santkumar/diya/README.md

# Diya
Light illumination device for cells cultured in multiwell plates or culture dishes

## hardware
- CAD files for hardware designs
- Assembly instructions

## software
- Source code for Diya GUI
- release version: executable files
