santkumar/diya/hardware/CAD_files/README.md

Contains .step and .stl files for all of the 3D printed parts of Diya.
