santkumar/diya/hardware/CAD_files/stands/README.md

This forms the 4 legs/stands of a Diya device. You need to print it 4 times for one set.
