santkumar/diya/hardware/CAD_files/diya_logo/README.md

This is the logo panel for Diya (can be seen in figures in the paper). This is not necessary for the operation of Diya, but it definitely gives a finishing look to the design :)

We would appreciate if you print and attach it on top of your Diya!
