santkumar/diya/hardware/CAD_files/back_plate/back_plate_complete.stl

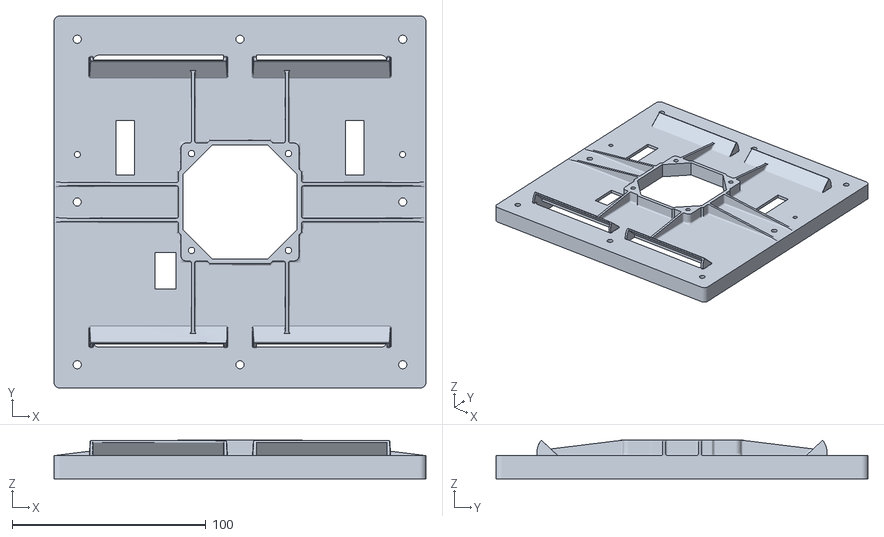
[picture p7: CAD file, 2023-09-17]
hardware/CAD_files/back_plate/back_plate_complete.stl
192.0 x 192.0 x 20.0
