santkumar/diya/hardware/CAD_files/back_plate/back_plate_part2.stl

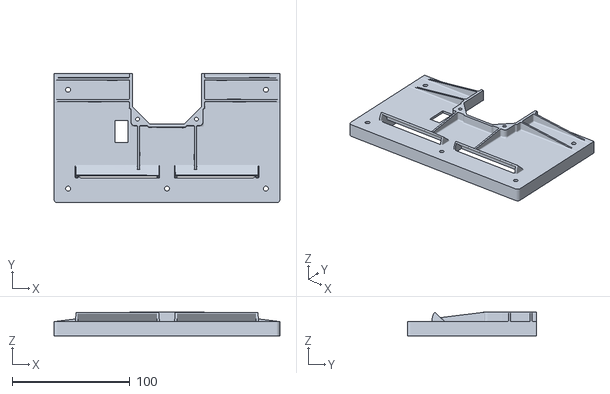
[picture p8: CAD file, 2023-09-17]
hardware/CAD_files/back_plate/back_plate_part2.stl
192.0 x 110.0 x 20.0
