santkumar/diya/hardware/CAD_files/diya_logo/diya_ctsb_eth_logo.step

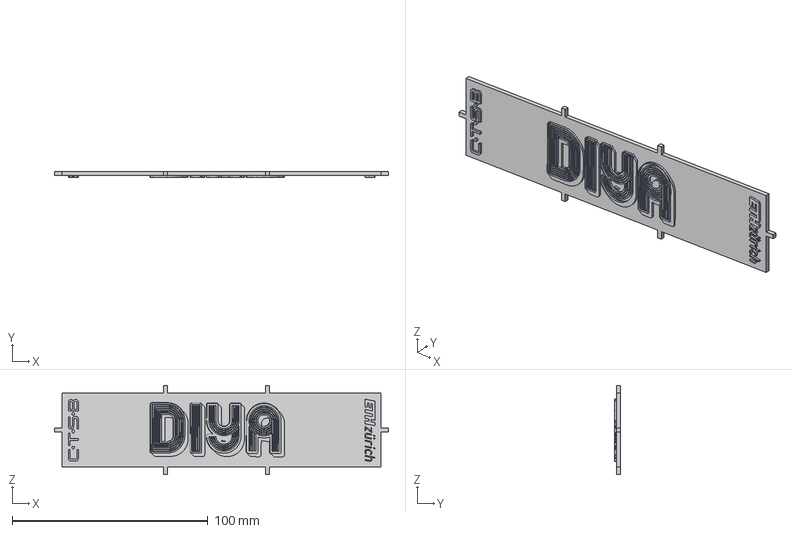
[picture p9: CAD file, 2023-09-17]
hardware/CAD_files/diya_logo/diya_ctsb_eth_logo.step
170.6 x 3.00 x 45.6 mm
