santkumar/diya/hardware/CAD_files/stands/stands.step

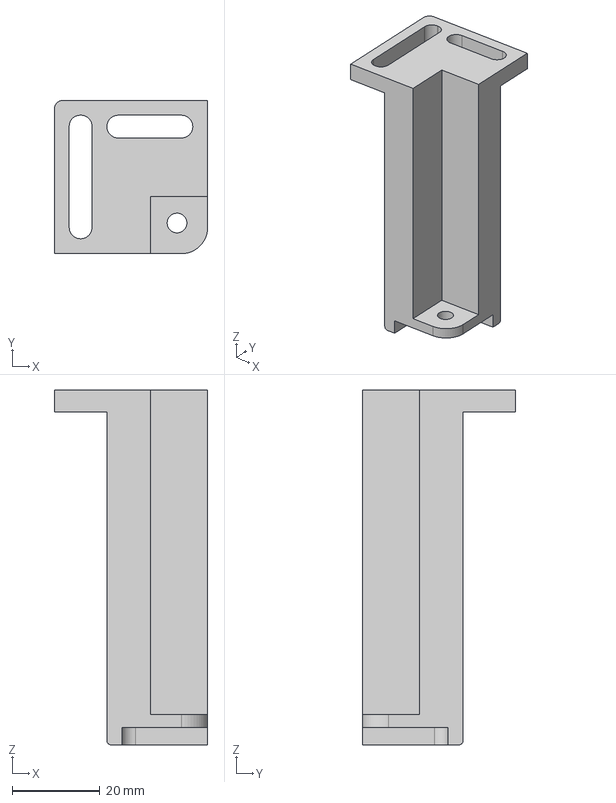
[picture p10: CAD file, 2023-09-17]
hardware/CAD_files/stands/stands.step
35.0 x 35.0 x 81.0 mm
