santkumar/diya/hardware/CAD_files/well_plate_adapters/6_well_plate_adapter.step

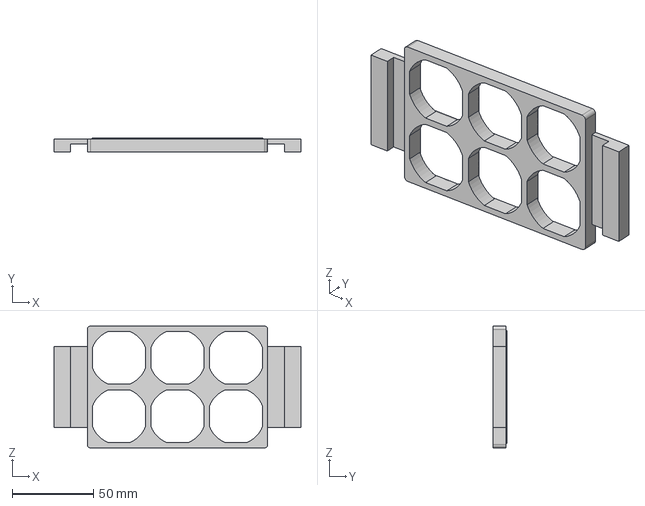
[picture p11: CAD file, 2023-09-17]
hardware/CAD_files/well_plate_adapters/6_well_plate_adapter.step
152.0 x 8.50 x 75.0 mm
