santkumar/diya/hardware/CAD_files/well_plate_clamper/side_clamps.step

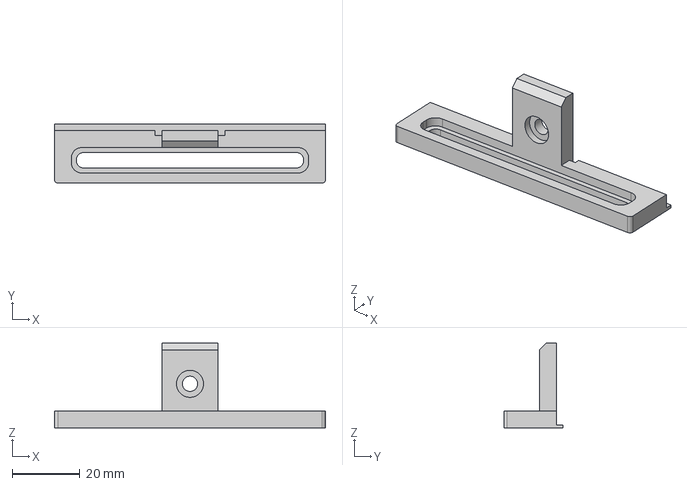
[picture p12: CAD file, 2023-09-17]
hardware/CAD_files/well_plate_clamper/side_clamps.step
80.0 x 17.5 x 25.0 mm
