santkumar/diya/hardware/CAD_files/back_plate/back_plate_part1.stl

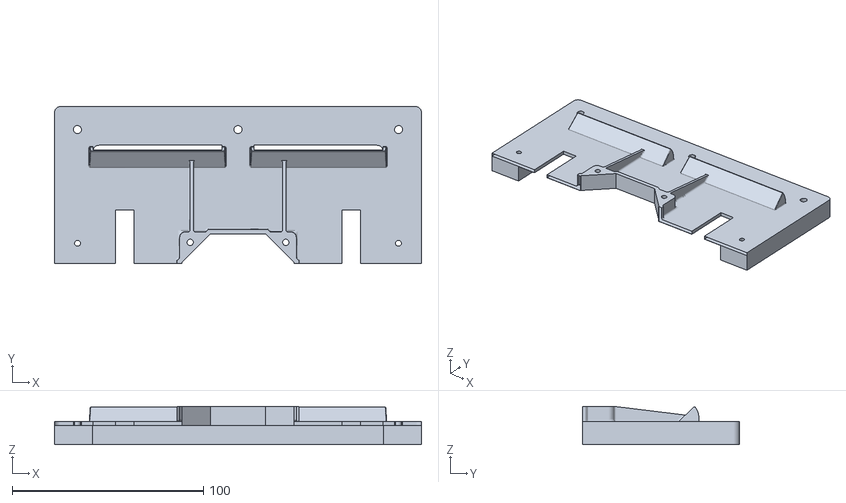
[picture p13: CAD file, 2023-09-17]
hardware/CAD_files/back_plate/back_plate_part1.stl
192.0 x 82.0 x 20.0
