santkumar/diya/hardware/CAD_files/well_plate_clamper/well_plate_clamper.step

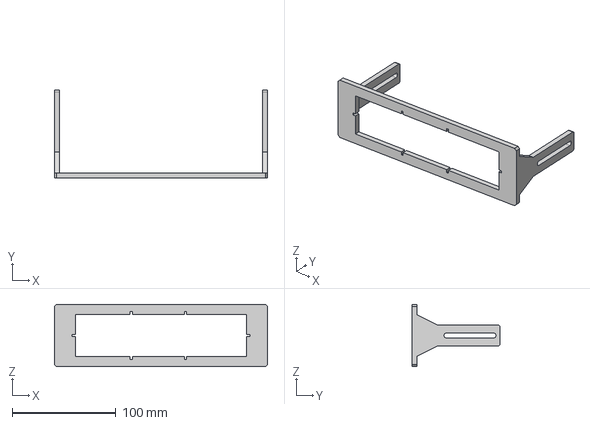
[picture p15: CAD file, 2023-09-17]
hardware/CAD_files/well_plate_clamper/well_plate_clamper.step
205.0 x 85.0 x 60.0 mm
