santkumar/diya/hardware/CAD_files/well_plate_adapters/96_U_bottom_adapter.stl

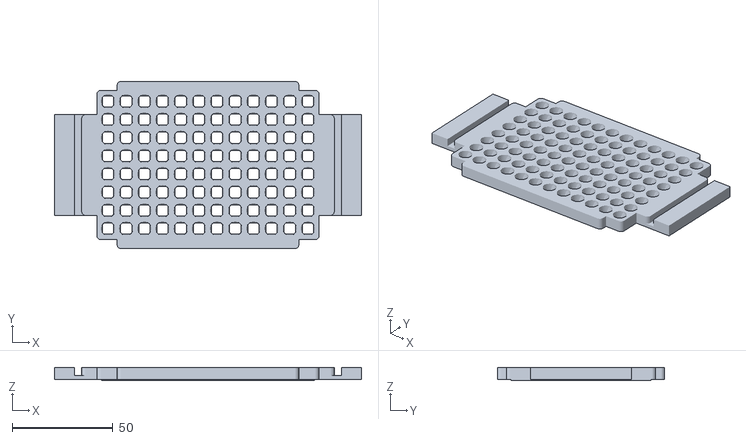
[picture p16: CAD file, 2023-09-17]
hardware/CAD_files/well_plate_adapters/96_U_bottom_adapter.stl
152.0 x 82.9 x 6.50
