santkumar/diya/hardware/CAD_files/well_plate_adapters/96_well_plate_adapter.stl

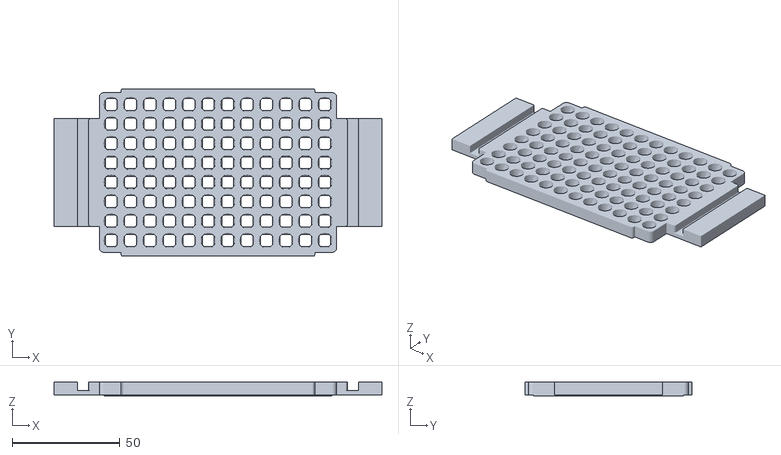
[picture p17: CAD file, 2023-09-17]
hardware/CAD_files/well_plate_adapters/96_well_plate_adapter.stl
152.0 x 77.6 x 6.50
