santkumar/diya/(list of files, cad)

Other CAD files:
hardware/CAD_files/diya_logo/diya_ctsb_eth_logo.stl
hardware/CAD_files/stands/stands.stl
hardware/CAD_files/well_plate_adapters/24_well_plate_adapter.stl
hardware/CAD_files/well_plate_adapters/6_well_plate_adapter.stl
hardware/CAD_files/well_plate_clamper/side_clamps.stl
hardware/CAD_files/well_plate_clamper/well_plate_clamper.stl
