santkumar/diya/hardware/assembly_instructions/README.md

This pdf contains step-by-step intructions for assembling a Diya device. The instructions assume that you have acquired and 3D printed all the parts needed for the assembly. Please refer to the paper for more details.

* Parts list is provided in the paper supplimentary information.
* CAD files for 3D printing are available in the hardware > CAD_files folder (in this repository).
