santkumar/diya/hardware/assembly_instructions/diya_assembly_instructions.pdf

## Step 0

- Acquire all parts (check parts list provided in the paper supplementary information) needed for assembling one Diya device
- Print the required 3D printed parts (check hardware > CAD_files folder)
- A set of screw drivers is needed in the assembly process

## Step 1

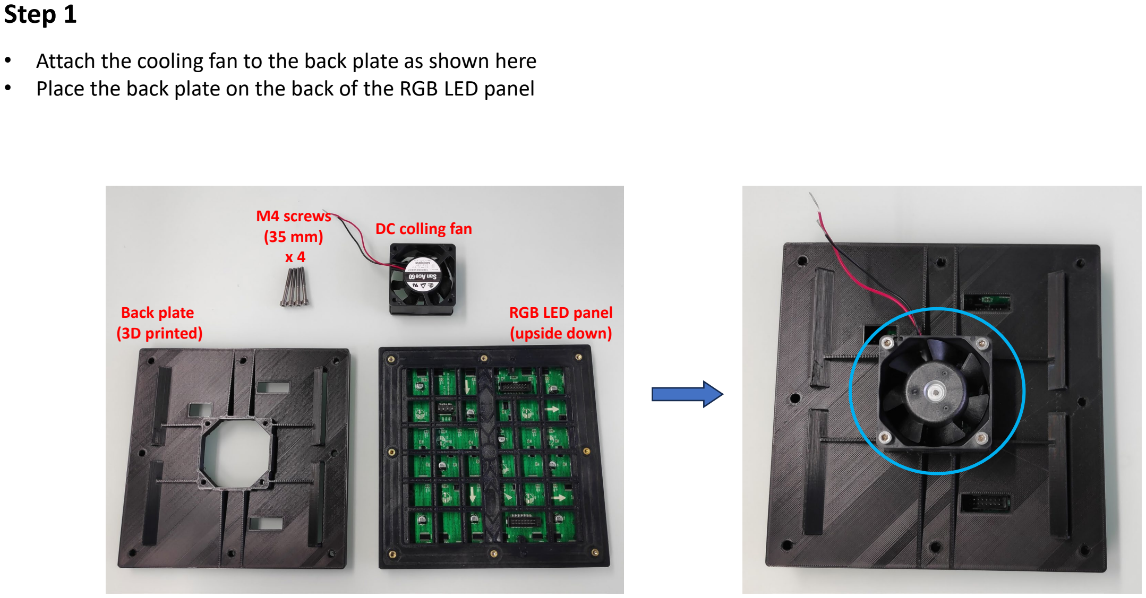
[picture p18: page 2]

- Attach the cooling fan to the back plate as shown here
- Place the back plate on the back of the RGB LED panel

Back plate
(3D printed)

RGB LED panel
(upside down)

M4 screws
(35 mm)
x 4

DC colling fan

## Step 2

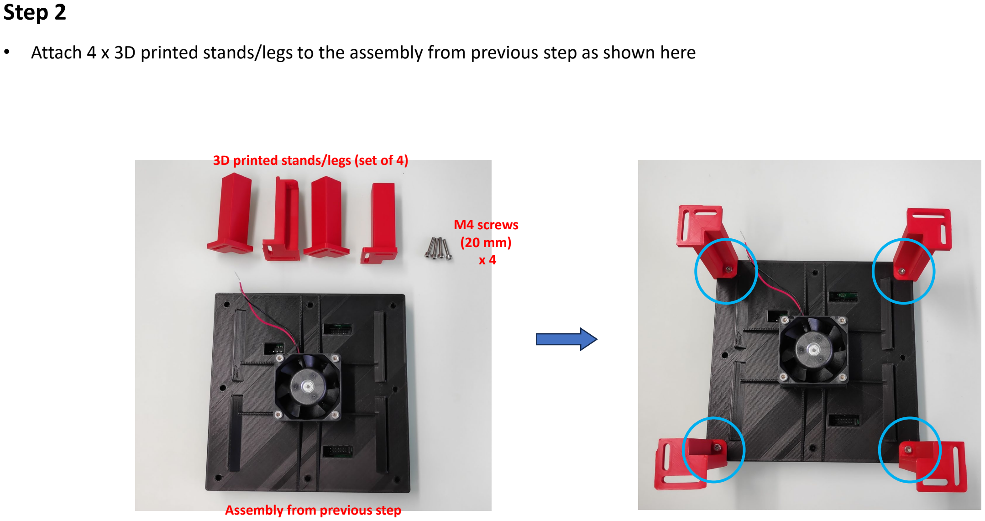
[picture p19: page 3]

- Attach 4 x 3D printed stands/legs to the assembly from previous step as shown here

Assembly from previous step

3D printed stands/legs (set of 4)

M4 screws
(20 mm)
x 4

## Step 3

- Attach 2 x 3D printed side clamps to the assembly from previous step as shown here

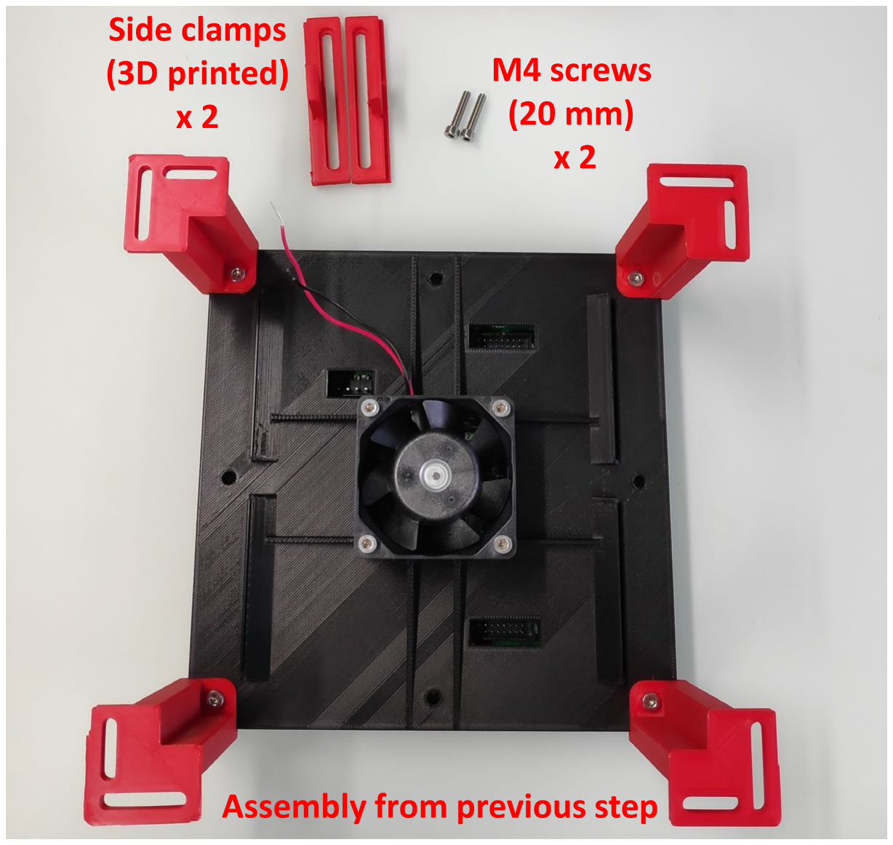
[picture p20: figure]
Assembly from previous step; Side clamps (3D printed) x 2; M4 screws (20 mm) x 2
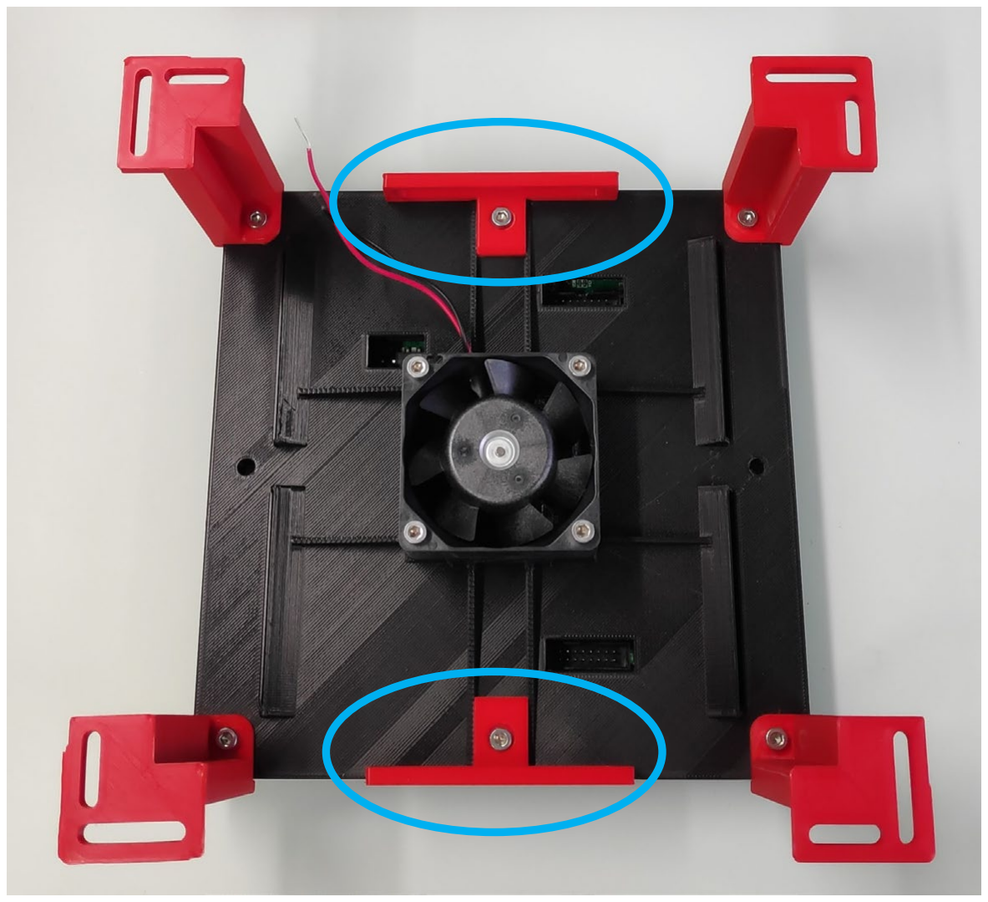
[picture p21: figure]

## Step 4

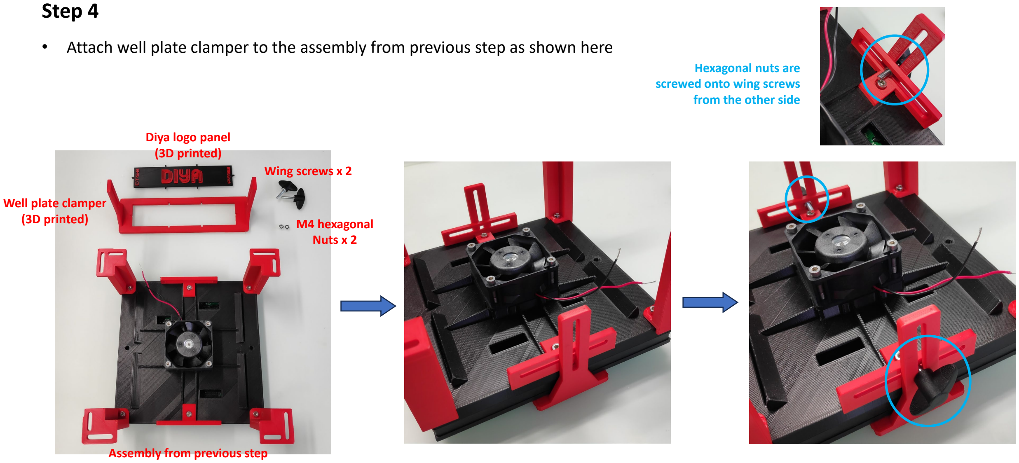
[picture p22: page 5]

- Attach well plate clamper to the assembly from previous step as shown here

Assembly from previous step

Well plate clamper
(3D printed)

Diya logo panel
(3D printed)
Wing screws x 2

M4 hexagonal
Nuts x 2

Hexagonal nuts are
screwed onto wing screws
from the other side

## Step 5 (Optional)

- Attach Diya logo panel to the well plate clamper as shown here
- Glue can be used to firmly attach the logo panel in place

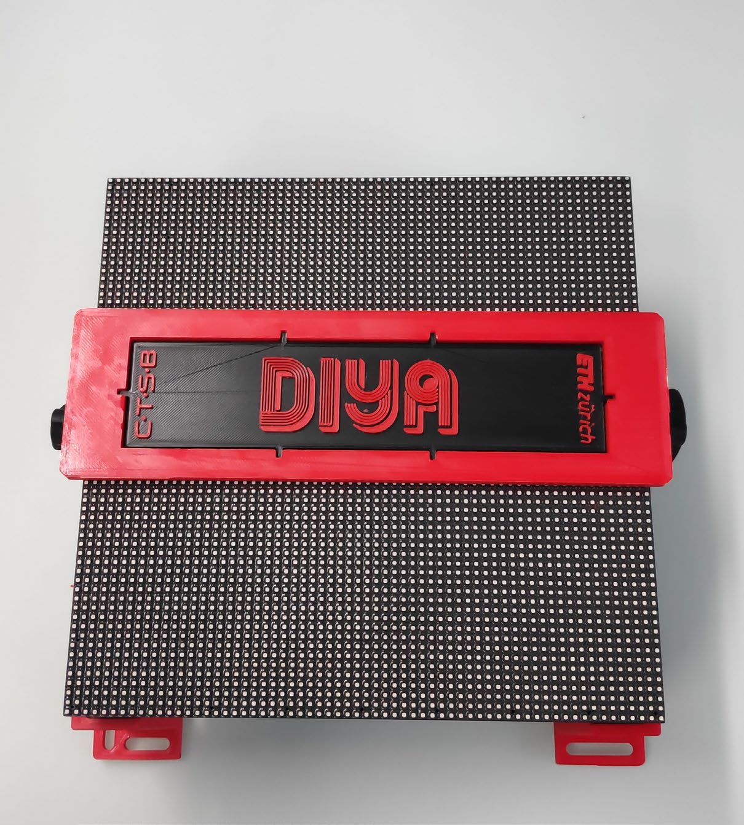
[picture p23: figure]

## Step 6

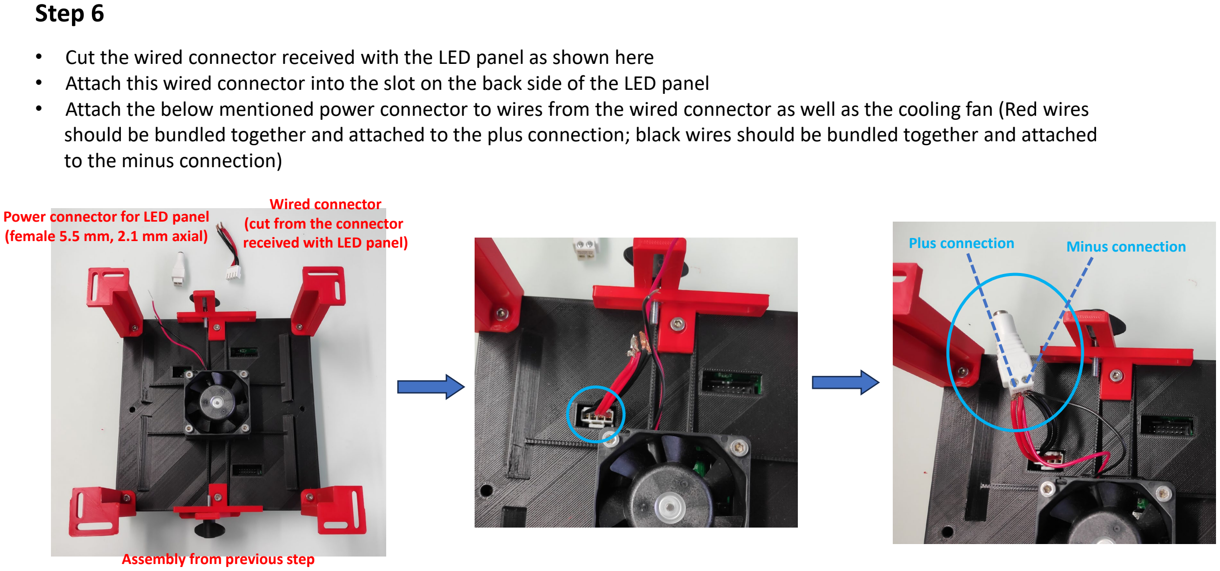
[picture p24: page 7]

- Cut the wired connector received with the LED panel as shown here
- Attach this wired connector into the slot on the back side of the LED panel
- Attach the below mentioned power connector to wires from the wired connector as well as the cooling fan (Red wires should be bundled together and attached to the plus connection; black wires should be bundled together and attached to the minus connection)

Assembly from previous step

Power connector for LED panel (female 5.5 mm, 2.1 mm axial)

Wired connector
(cut from the connector
received with LED panel) | Plus connection | Minus connection

## Step 7

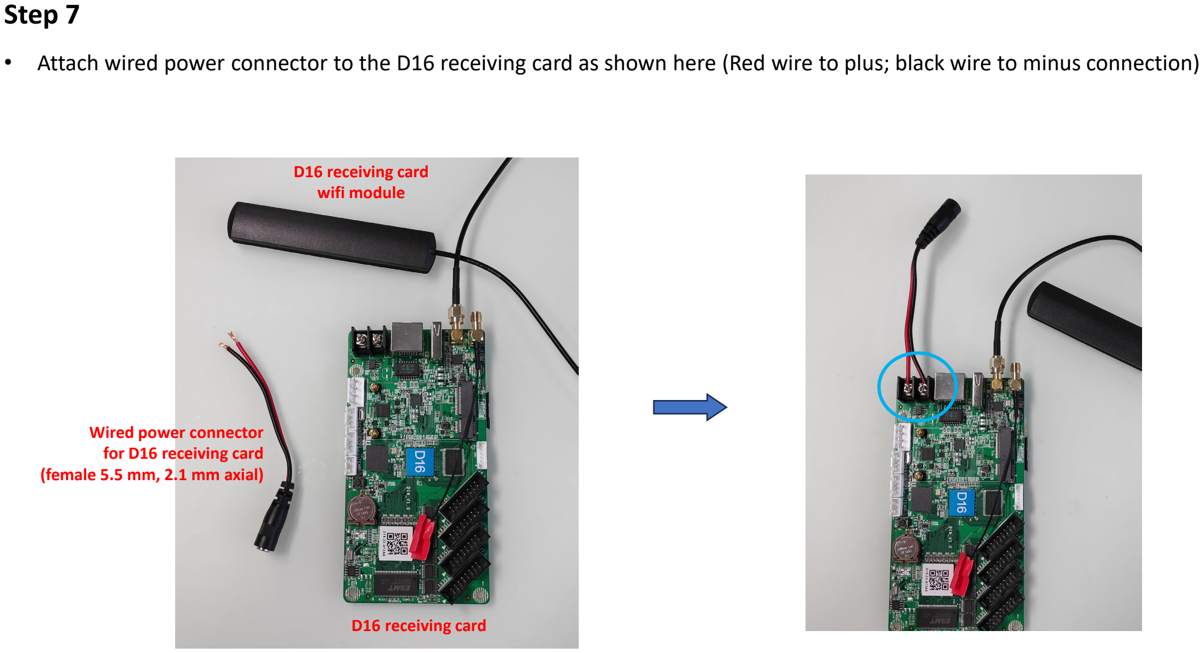
[picture p25: page 8]

- Attach wired power connector to the D16 receiving card as shown here (Red wire to plus; black wire to minus connection)

Wired power connector
for D16 receiving card
(female 5.5 mm, 2.1 mm axial)

D16 receiving card
wifi module

D16 receiving card

## Step 8

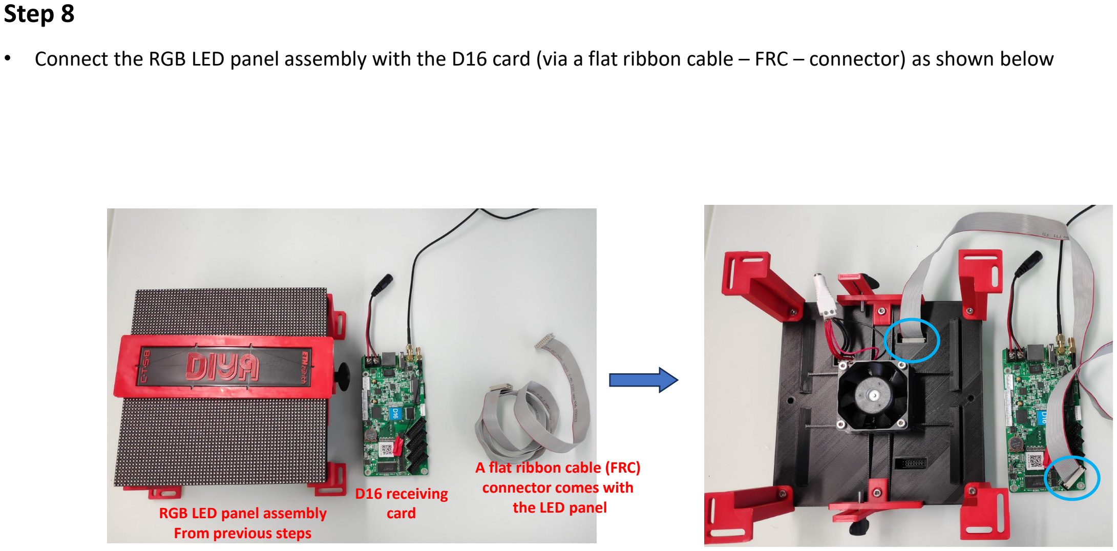
[picture p26: page 9]

- Connect the RGB LED panel assembly with the D16 card (via a flat ribbon cable – FRC – connector) as shown below

RGB LED panel assembly
From previous steps

A flat ribbon cable (FRC)
connector comes with
the LED panel D16 receiving card

## Step 9

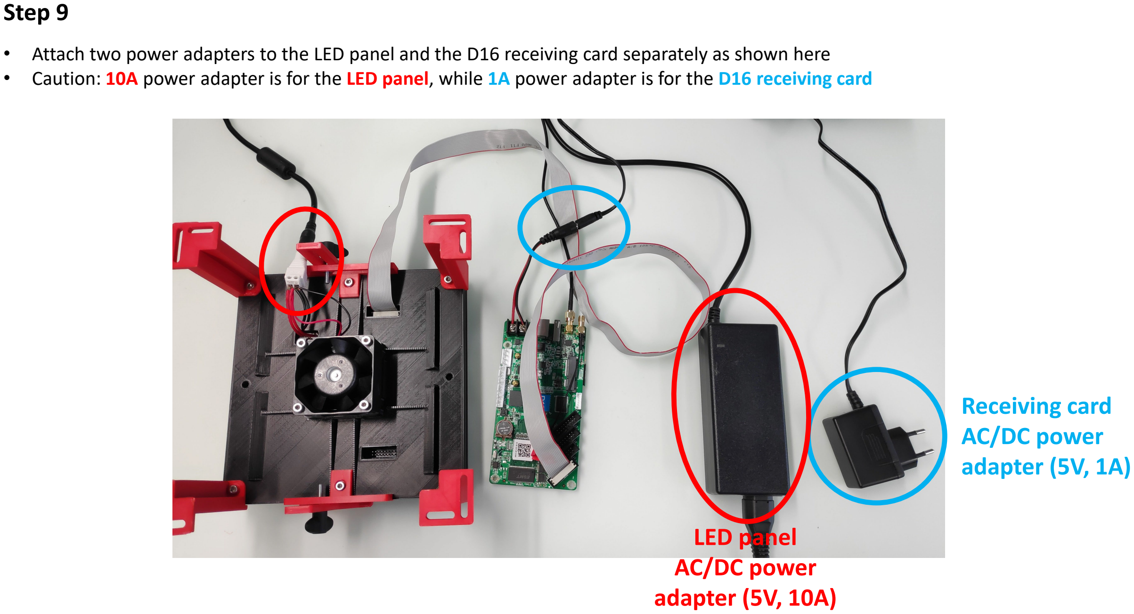
[picture p27: page 10]

- Attach two power adapters to the LED panel and the D16 receiving card separately as shown here
- Caution: 10A power adapter is for the LED panel, while 1A power adapter is for the D16 receiving card

## Receiving card AC/DC power adapter (5V, 1A)

## LED panel AC/DC power adapter (5V, 10A)

## Step 10

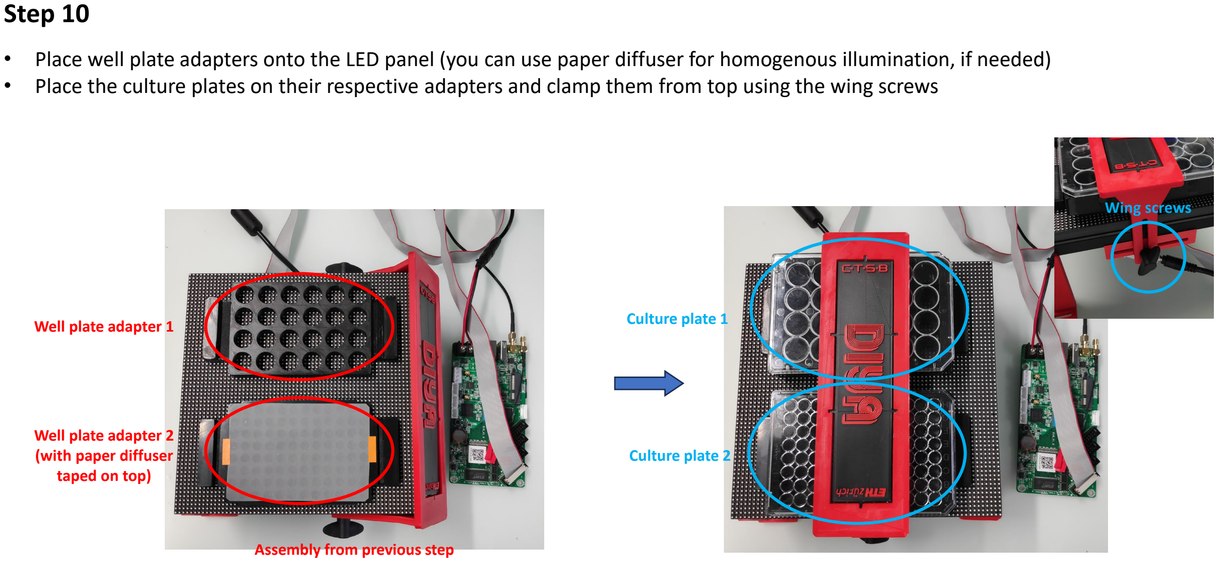
[picture p28: page 11]

- Place well plate adapters onto the LED panel (you can use paper diffuser for homogenous illumination, if needed)
- Place the culture plates on their respective adapters and clamp them from top using the wing screws

Well plate adapter 1

Well plate adapter 2
(with paper diffuser
taped on top)

Assembly from previous step

Wing screws

Culture plate 1

Culture plate 2
