santkumar/diya/(commit log)

2023-03-27 Added hardware folder
    [24_well_plate_adapter.f3d, 96_well_plate_adapter.f3d, panel_stand_left.f3d, panel_stand_right.f3d]
2023-09-17 Added back plate CAD files
    [back_plate_complete.stl, back_plate_part1.stl, back_plate_part2.stl]
2023-09-17 Added logo panel files
    [diya_ctsb_eth_logo.step, diya_ctsb_eth_logo.stl]
2023-09-17 Added stands file
    [stands.step, stands.stl]
2023-09-17 Added multiwell plate adapter files
    [24_well_plate_adapter.step, 24_well_plate_adapter.stl, 6_well_plate_adapter.step, 6_well_plate_adapter.stl, 96_U_bottom_adapter.stl, 96_well_plate_adapter.stl]
2023-09-17 Added well plate clamper design files
    [side_clamps.step, side_clamps.stl, well_plate_clamper.step, well_plate_clamper.stl]
2023-09-17 Added assembly instructions for Diya
